vladiclick/hx18-hexapod/final-concept-st3215/renders/HX18-ST3215-underside.png

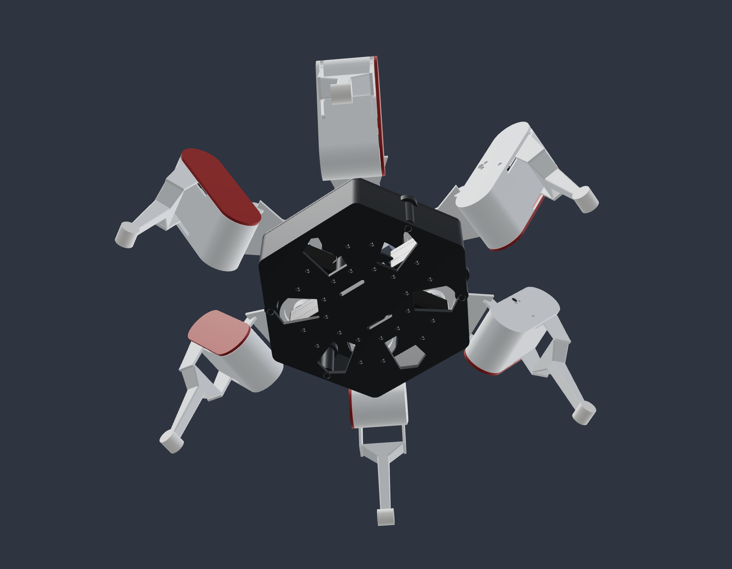
final-concept-st3215/renders/HX18-ST3215-underside.png
