vladiclick/hx18-hexapod/final-concept/HX18-Core-open.png

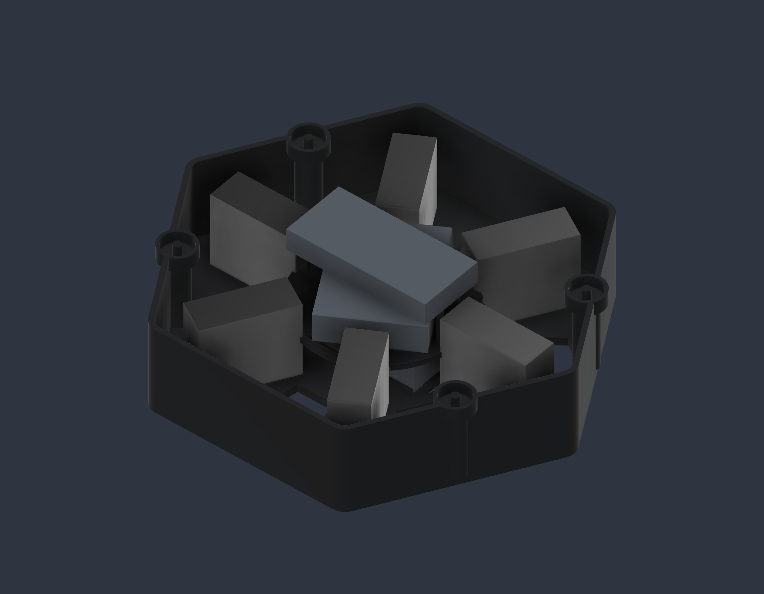
final-concept/HX18-Core-open.png
