vladiclick/hx18-hexapod/final-concept/HX18-Inline-V5-preview.png

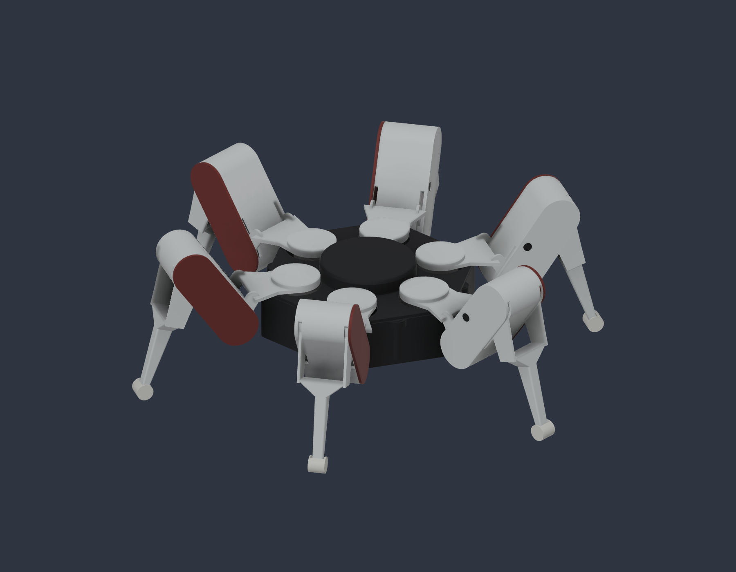
final-concept/HX18-Inline-V5-preview.png
