vladiclick/hx18-hexapod/final-concept/HX18-Top.png

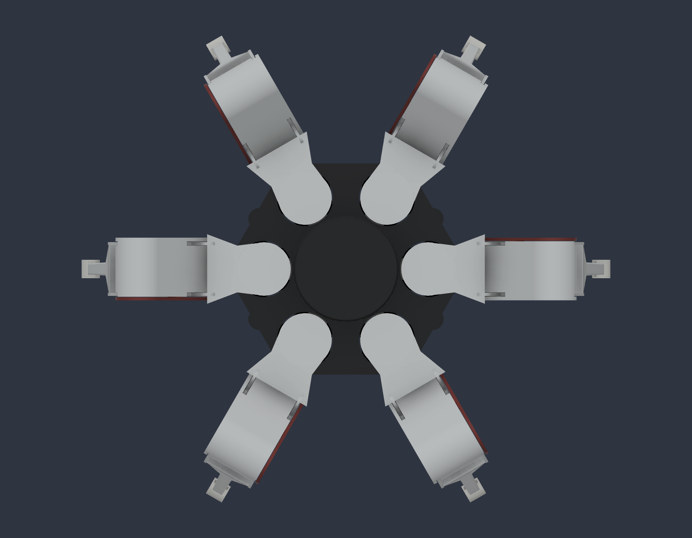
final-concept/HX18-Top.png
