vladiclick/hx18-hexapod/final-concept/HX18-Underside.png

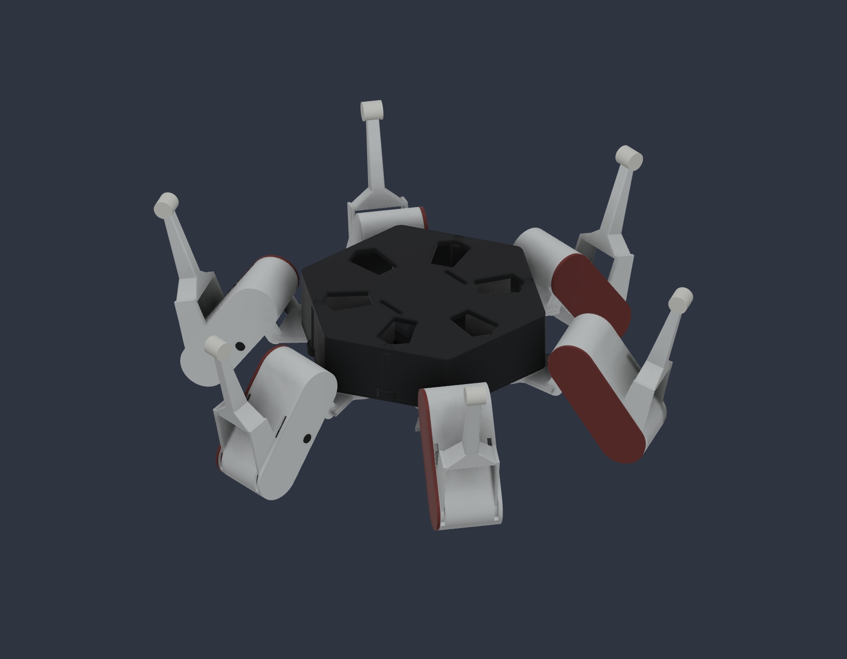
final-concept/HX18-Underside.png
