vladiclick/hx18-hexapod/final-concept/V5-One-leg-edge.png

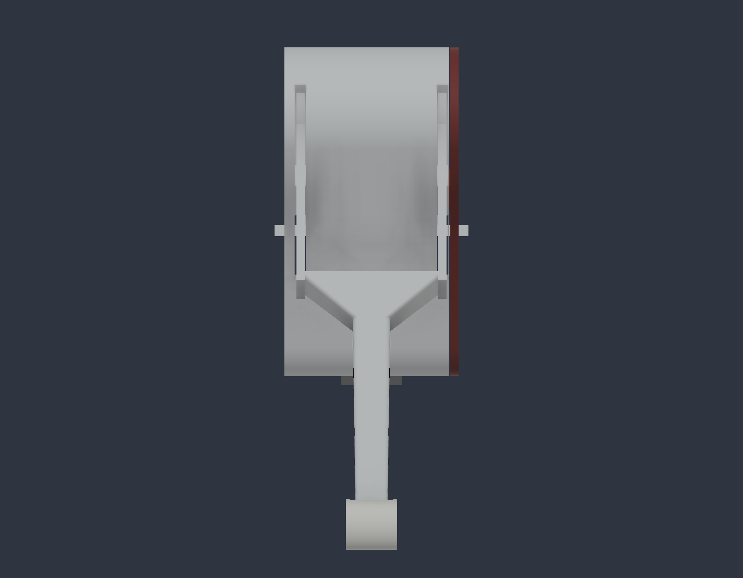
final-concept/V5-One-leg-edge.png
