vladiclick/hx18-hexapod/final-concept/V5-One-leg-front.png

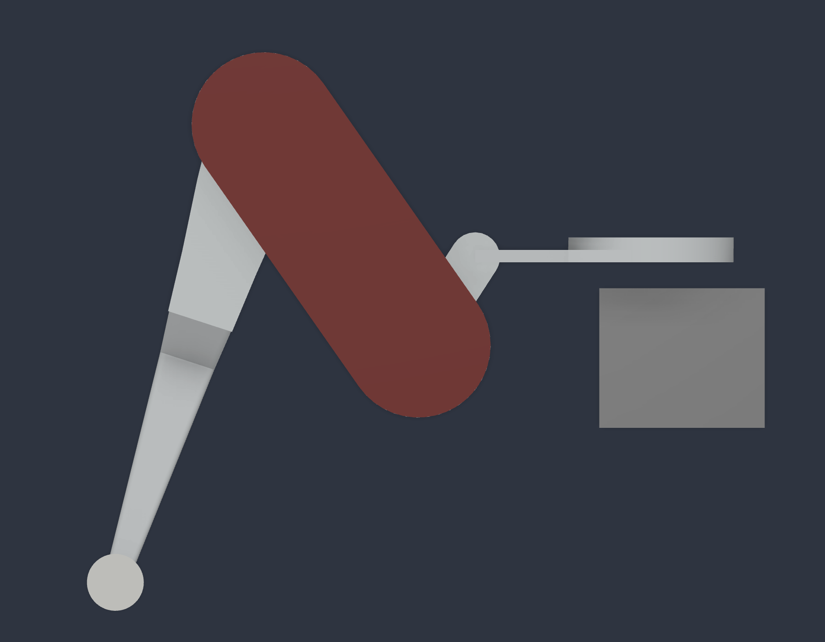
final-concept/V5-One-leg-front.png
