vladiclick/hx18-hexapod/final-concept/V5-One-leg-rear.png

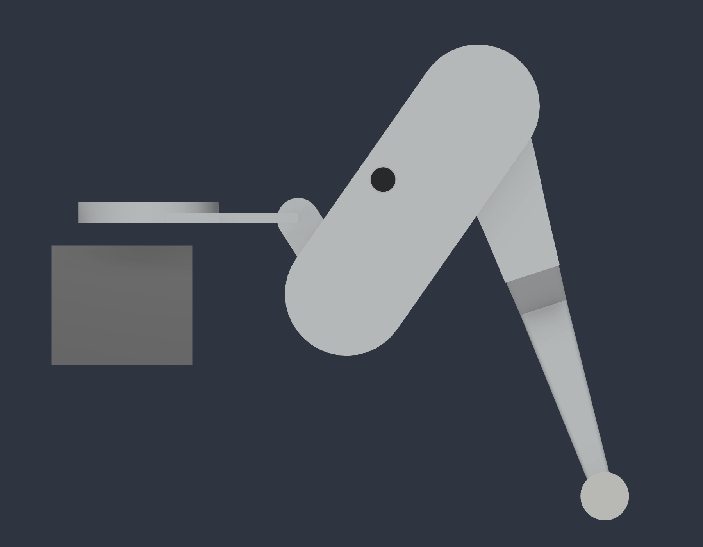
final-concept/V5-One-leg-rear.png
