vladiclick/hx18-hexapod/v2/Core-electronics.png

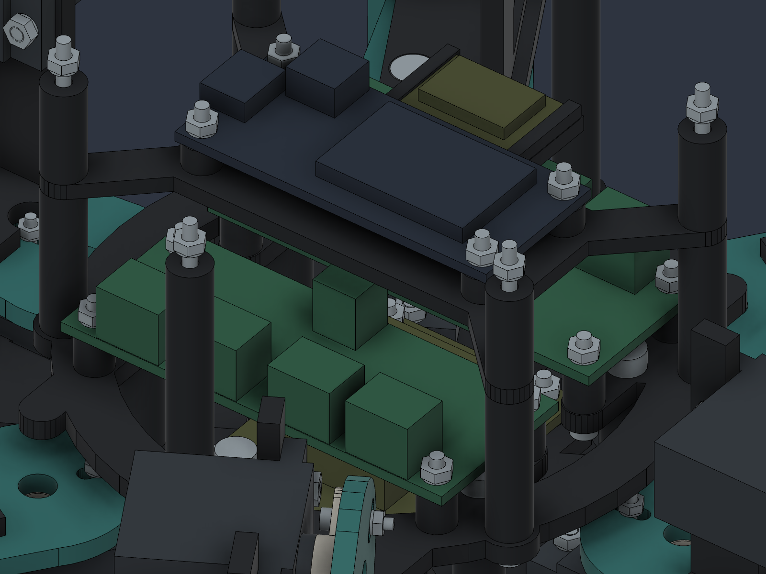
v2/Core-electronics.png
