vladiclick/hx18-hexapod/v2/Core-PCA-power.png

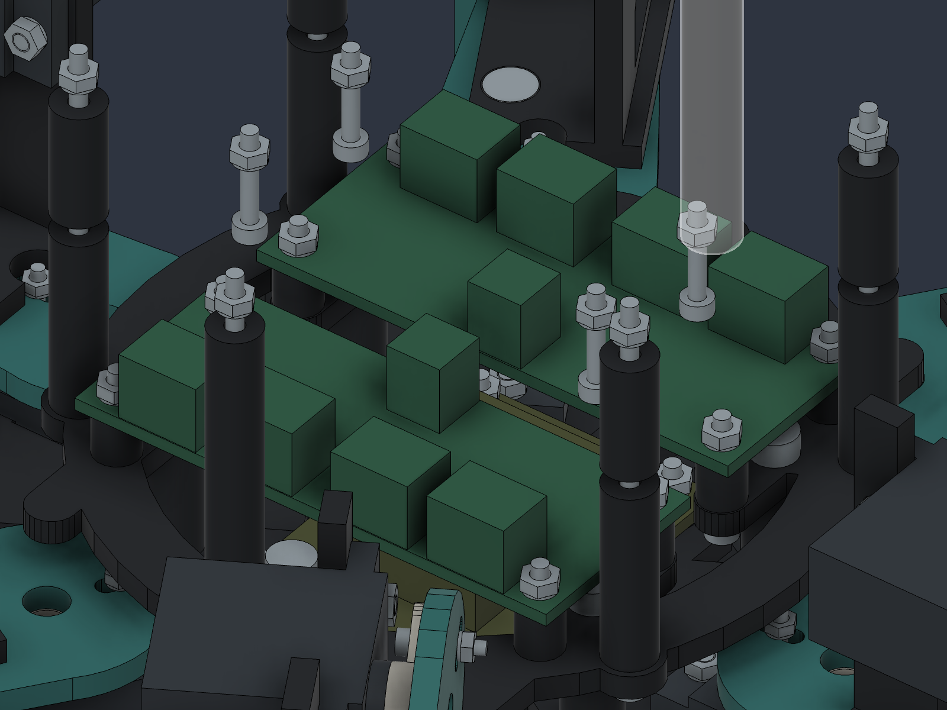
v2/Core-PCA-power.png
