vladiclick/hx18-hexapod/v2/HX18-preview.png

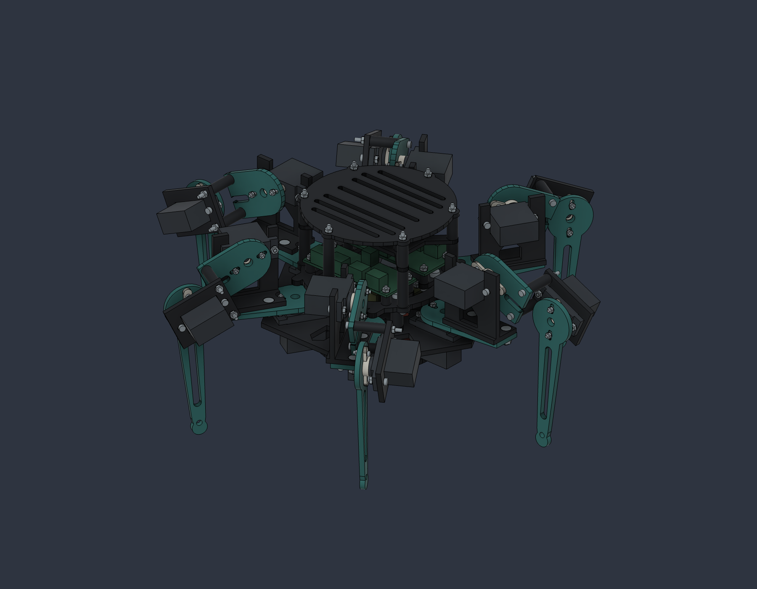
v2/HX18-preview.png
