vladiclick/hx18-hexapod/v2/Electronics/BOM-electronics.csv

Referință | Cantitate | Statut selecție | Componentă | Model/specificație | L_mm | W_mm | H_mm | Masă_per_unitate_g | Rol și observații | Sursă primară | Validare rămasă
MCU1 | 1 | produs exact | Adafruit Feather ESP32 V2 fără header-e GPIO înalte | 5400 | 50.8 | 22.86 | 6.37 | 6 | PCB50.8x22.86; produs overall52.3x22.8x7.2; USB-C | https://www.adafruit.com/product/5400 | pini/găuri oficiale; PCB real de verificat
PWM-A;PWM-B | 2 | produs exact | Adafruit PCA9685 16 Channel PWM Servo Driver | 815 rev C | 62.23 | 25.4 | 12.10 | 9 | înălțime model: z−2.01..10.09; V+ neconectat în topologia externă | https://www.adafruit.com/product/815 | 0x40 și0x41; A0 numai pe B
REG-S | 1 | produs exact | Pololu 5V Step-Down D42V110F5 | 5671 | 31.75 | 43.18 | 9 | 15 | 5V±3%; 8–15A tipic dependent de VIN/răcire | https://www.pololu.com/product/5671 | teste la VIN6.6–8.4V și sarcina reală
REG-L | 1 | produs exact | Pololu 5V 1A Step-Down D24V10F5 | 2831 | 12.7 | 17.78 | 3.56 | 1 | logică prin cablu USB-C; nu alimentează servouri | https://www.pololu.com/product/2831/specs | cradle izolator fără găuri
BAT1 | 1 | produs exact | Gens ace Adventure 450mAh 2S 60C | GEA4502S60XT3 | 43 | 23 | 13 | 28 | 7.4Vnominal/8.4Vfull; XT30; G-Tech-3P pentru încărcare | https://gensace.de/fr/collections/product-download/products/gea4502s60xt3 | dimensiuni și masă aproximative; disponibilitate de confirmat
SV0..SV17 | 18 | produs exact | TowerPro MG90S metal gear | MG90S | 22.8 | 12.2 | 28.5 | 13.4 | 1.8kgfcm stall@4.8V; curent stall nepublicat oficial | https://towerpro.com.tw/product/mg90s-3/ | modele și horn-uri reale de verificat; clonele diferă
R-OE | 1 | specificație | Rezistor axial metal-film | 1kΩ 1% minimum0.125W |  |  |  |  | OE comun→Feather3V; ambele R7 de10kΩ păstrate | https://github.com/adafruit/Adafruit-16-Channel-PWM-Servo-Driver-PCB | valoare proiectată; nu cod de achiziție
C-A;C-B | 2 | specificație | Condensator electrolitic low-ESR | 1000µF minimum10V |  |  |  |  | câte unul pe fiecare bancă5V; polaritate corectă |  | alegere inițială; produs/dimensiuni după măsurători
F1 | 1 | specificație provizorie | Siguranță fuzibilă DC pentru intrare | 7A țintă provizorie |  |  |  |  | rating DC≥12V; valoarea/curba verificate cu curent real | https://www.littelfuse.com/assetdocs/automotive-passenger-car-catalog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 | 7A nu este7A limită la ieșire; nu cod comandabil definit
FH1 | 1 | specificație | Portsiguranță inline izolat | compatibil F1 și curentul ramurii |  |  |  |  | montaj aproape de pozitiv BAT; clemă/strain-relief |  | gabarit adaptat după produs real
D0;D1;HARNESS | 2 | specificație | Pereche mufă XT30 plus fire izolate | tip compatibil exact cu bateria |  |  |  |  | D0baterie; D1deconectare ramură VIN servo; contacte potrivite |  | sex/polaritate verificate; nu scurtcircuita; mase comune
USB-PWR | 1 | specificație | Cablu USB-C conform pentru alimentare | scurt cu VBUS/GND identificate |  |  |  |  | buck logic5V→USB-CFeather; scos înainte de USB computer |  | mufa/cablul real determină keepout
ADAPTER0..17 | 18 | specificație | Adaptor/prelungitor JR servo | semnal separat de +/GND |  |  |  |  | oranj→PCA PWM; roșu/maro→distribuție externă |  | contacte și polaritate verificate; nu Dupont pentru magistrala putere
PWR-WIRE | 1 | specificație | Set fire flexibile silicon | 18AWG principal;22AWG ramură picior |  |  |  |  | lungime după rutarea CAD; curent/cădere tensiune verificate |  | secțiuni propuse pentru trasee scurte; ajustează după test
LOGIC-WIRE | 1 | specificație | Set5 fire logică/GND pentru două plăci | 26–28AWG izolate |  |  |  |  | 3V,GND,SDA,SCL,OE; fire scurte |  | conectori/sudură cu strain-relief
BMS/MON | 1 | necesar înainte de mers pe baterie | Monitor/protector LiPo2S pe fiecare celulă | compatibilG-Tech-3P; prag validat |  |  |  |  | firmware ADC și protecție hardware nu sunt instalate |  | nu este inclus/fictiv; alege după pack real
CHARGER | 1 | echipament extern | Încărcător balance2S LiPo | compatibilG-Tech-3P +XT30 |  |  |  |  | bateria scoasă/deconectată de robot; încărcare echilibrată | https://gensace.de/fr/collections/product-download/products/gea4502s60xt3 | nu se încarcă din Feather USB
HW-PCB | 12 | specificație | Set M2 șurub+șaibă/distanțier izolat | lungime măsurată |  |  |  |  | 4Feather+8PCA; găurile PCB nu acceptăM3 |  | diametru/lungime validate pe print real
HW-REG | 4 | specificație | Set M2 pentru buck servo | M2×10mm; lungime finală verificată |  |  |  |  | găuriØ2.18; componente sub PCB1.8mm |  | cradle pentru bucklogic fără găuri
