vladiclick/hx18-hexapod/final-concept/final-concept-assembly.stl

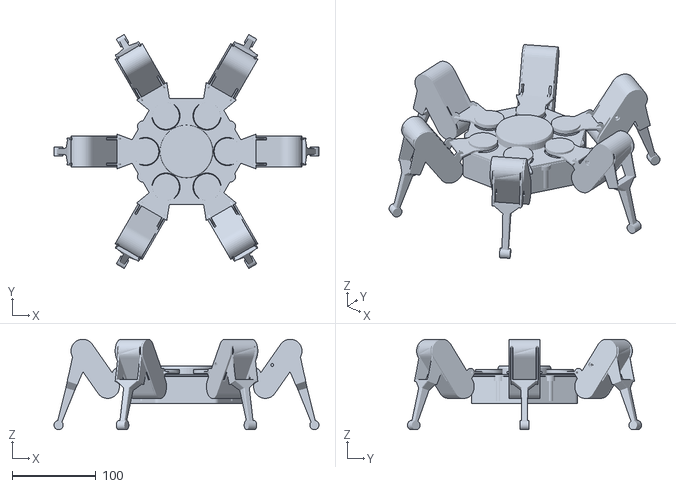
[picture p21: CAD file, 2026-10-26]
final-concept/final-concept-assembly.stl
316.1 x 279.3 x 107.9
