vladiclick/hx18-hexapod/final-concept-st3215/hx18-final-concept-st3215.step

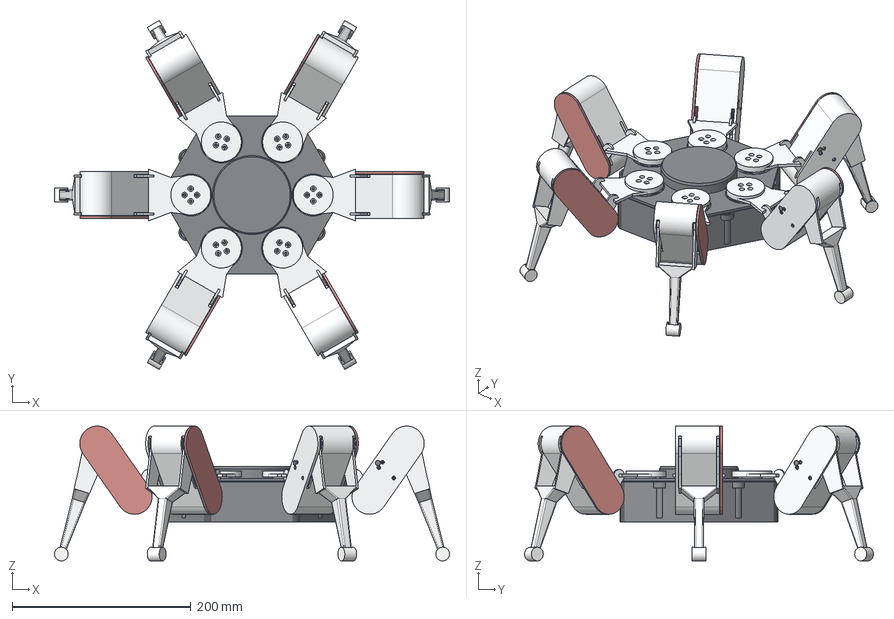
[picture p22: CAD file, 2026-10-28]
final-concept-st3215/hx18-final-concept-st3215.step
442.6 x 391.0 x 151.1 mm
Core tub
Core lid
Electronics cassette
Battery keep-out
Regulator keep-out
ESP32 keep-out
Lid screw M3x40 1 x 4
Cassette screw M3x6 1 x 2
coxa x 6
femur x 6
femur cover x 6
tibia x 6
foot pad x 6
middle case x 18
top case x 18
bottom case x 18
drive horn x 18
idler horn x 18
Leg 1 cover screw M3x45 x 6
