vladiclick/hx18-hexapod/final-concept-st3215/STL/FootPad.stl

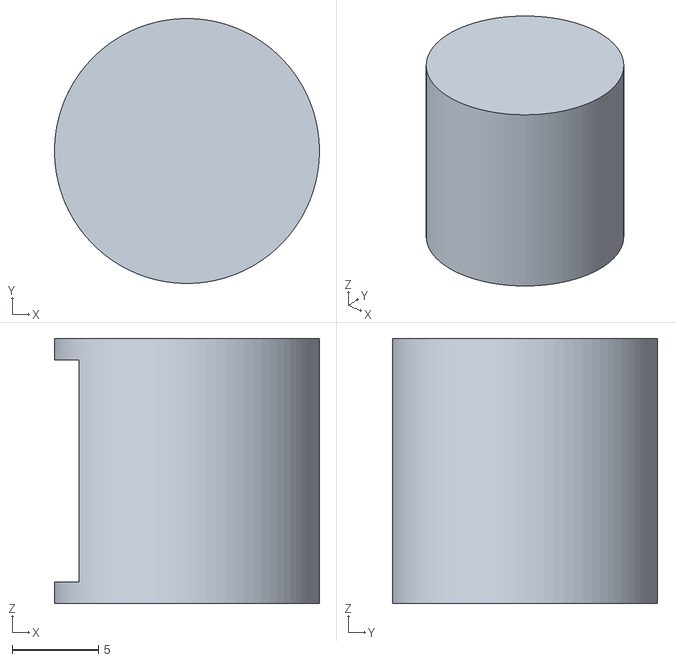
[picture p23: CAD file, 2026-10-28]
final-concept-st3215/STL/FootPad.stl
15.4 x 15.4 x 15.4
