vladiclick/hx18-hexapod/v2/HX18-MG90S.step

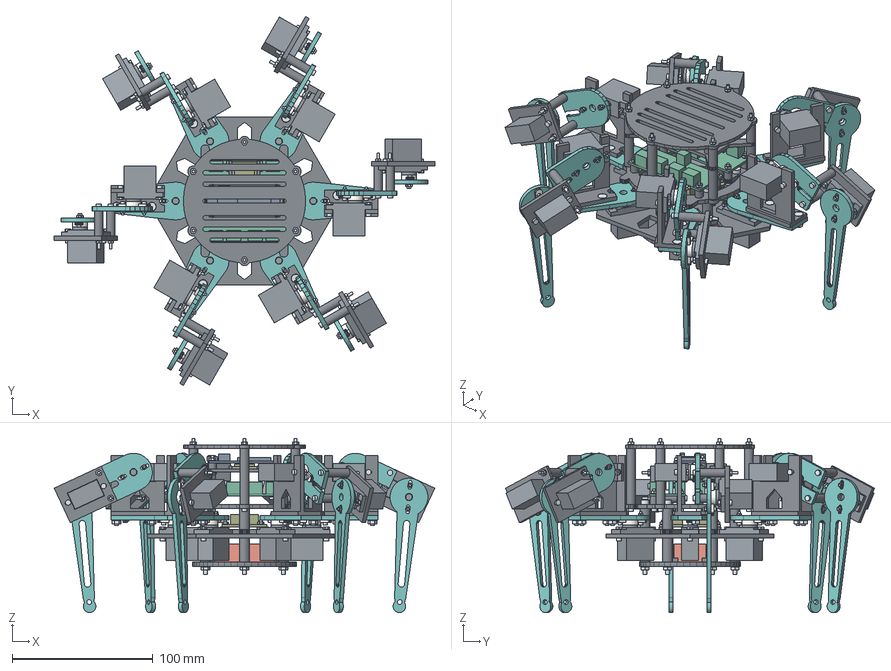
[picture p24: CAD file, 2026-10-26]
v2/HX18-MG90S.step
270.9 x 262.6 x 124.0 mm
