vladiclick/hx18-hexapod/v2/STL/GuardLower.stl

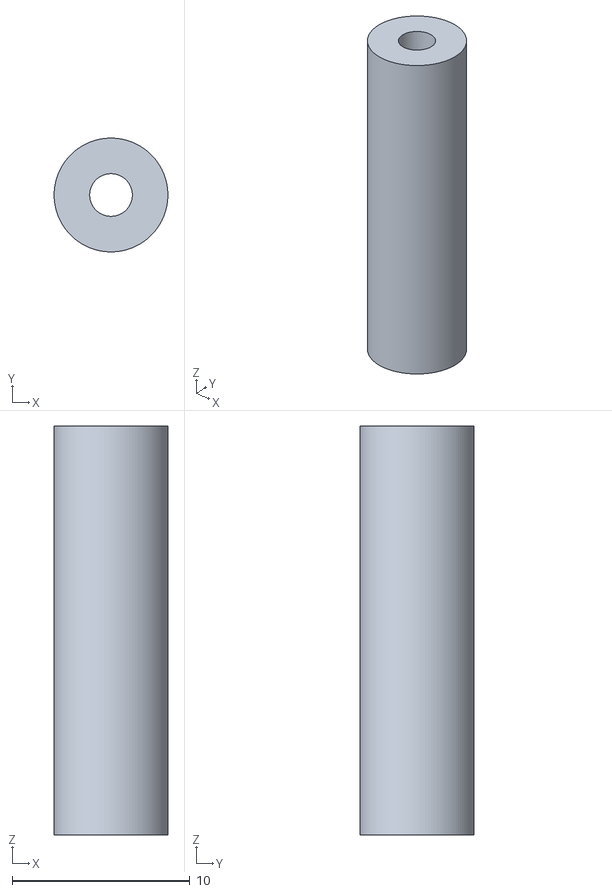
[picture p25: CAD file, 2026-10-26]
v2/STL/GuardLower.stl
6.40 x 6.40 x 23.0
