vladiclick/hx18-hexapod/final-concept-st3215/hx18-final-concept-st3215-printed-parts.stl

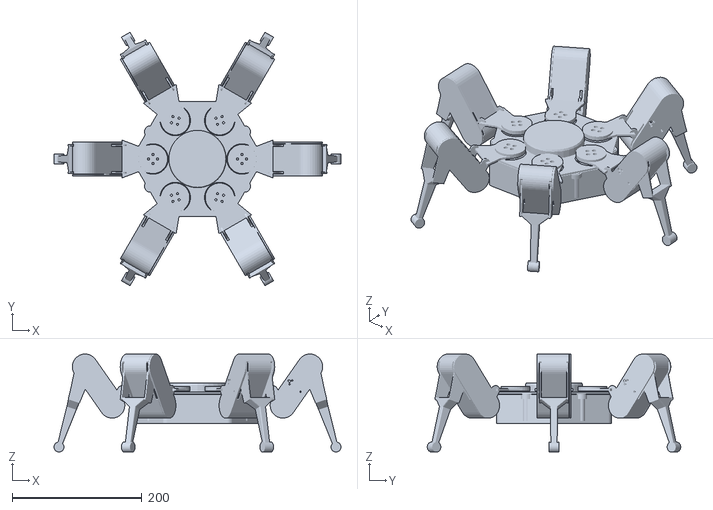
[picture p26: CAD file, 2026-10-28]
final-concept-st3215/hx18-final-concept-st3215-printed-parts.stl
442.5 x 390.9 x 151.1
