vladiclick/hx18-hexapod/final-concept-st3215/STL/ElectronicsCassette.stl

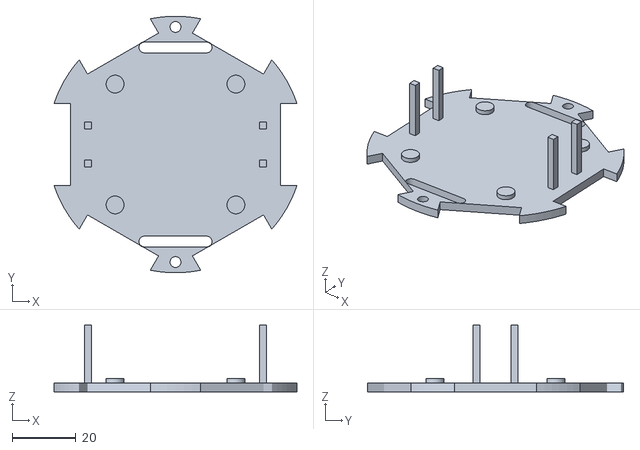
[picture p27: CAD file, 2026-10-28]
final-concept-st3215/STL/ElectronicsCassette.stl
76.4 x 80.6 x 21.0
