vladiclick/hx18-hexapod/final-concept/final-concept.step

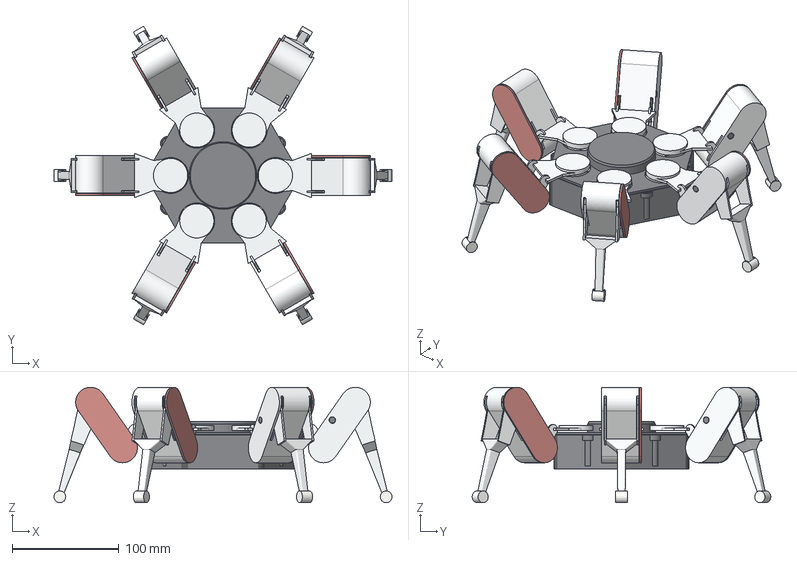
[picture p28: CAD file, 2026-10-26]
final-concept/final-concept.step
316.1 x 279.3 x 107.9 mm
