vladiclick/hx18-hexapod/v2/STL/UpperSpacer.stl

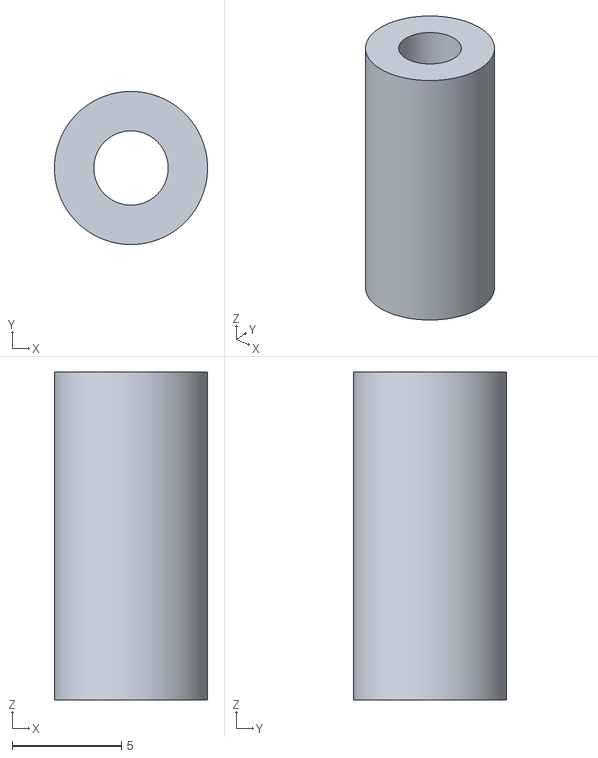
[picture p29: CAD file, 2026-10-26]
v2/STL/UpperSpacer.stl
7.00 x 7.00 x 15.0
