vladiclick/hx18-hexapod/final-concept-st3215/STL/FemurCheek.stl

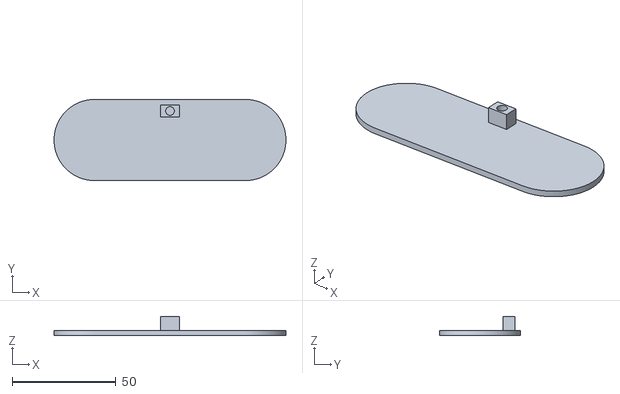
[picture p30: CAD file, 2026-10-28]
final-concept-st3215/STL/FemurCheek.stl
112.0 x 39.2 x 9.18
