vladiclick/hx18-hexapod/v2/STL/Chassis.stl

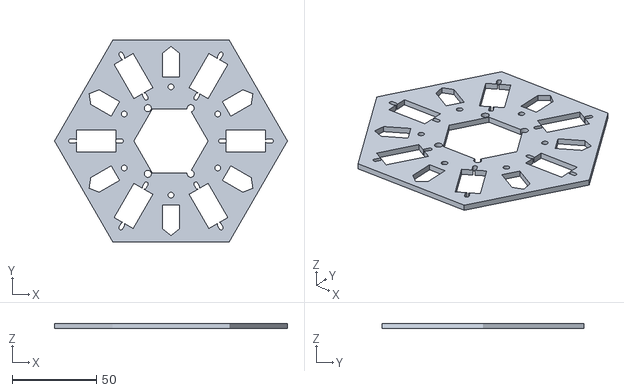
[picture p31: CAD file, 2026-10-26]
v2/STL/Chassis.stl
138.0 x 119.5 x 3.00
