vladiclick/hx18-hexapod/final-concept-st3215/STL/CoreTub.stl

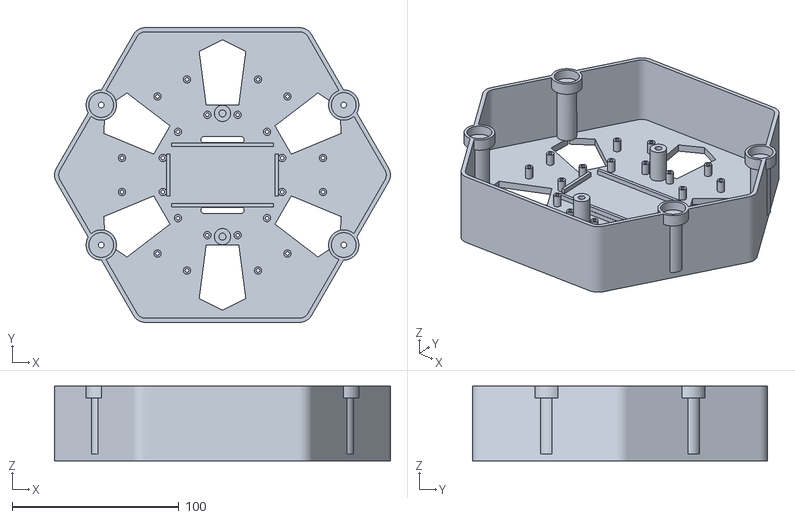
[picture p32: CAD file, 2026-10-28]
final-concept-st3215/STL/CoreTub.stl
201.6 x 176.8 x 44.8
