vladiclick/hx18-hexapod/v2/STL/FitCoupon.stl

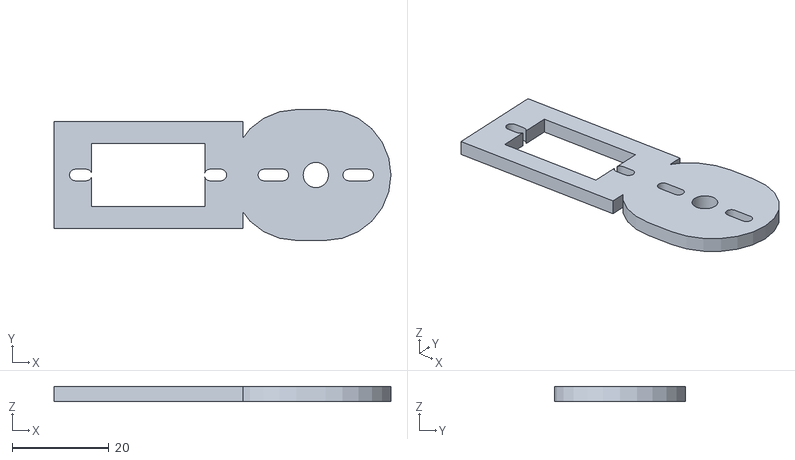
[picture p33: CAD file, 2026-10-26]
v2/STL/FitCoupon.stl
69.5 x 27.0 x 3.00
