vladiclick/hx18-hexapod/final-concept-st3215/STL/Tibia.stl

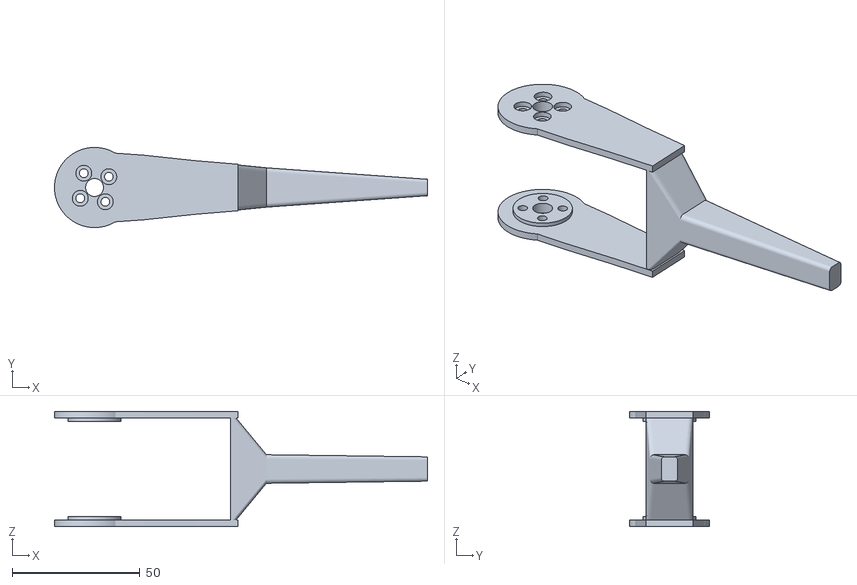
[picture p34: CAD file, 2026-10-28]
final-concept-st3215/STL/Tibia.stl
145.9 x 31.4 x 45.1
