vladiclick/hx18-hexapod/v2/STL/GuardTall.stl

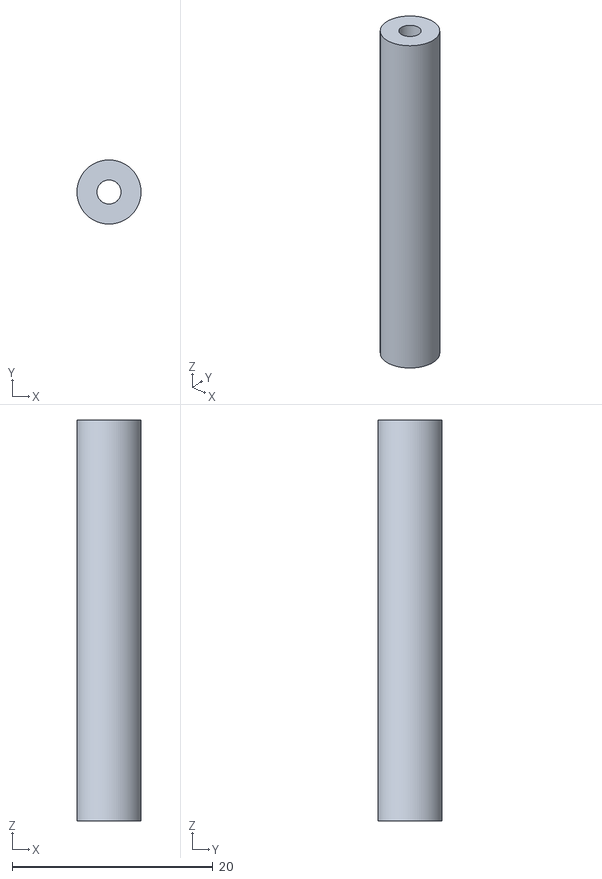
[picture p35: CAD file, 2026-10-26]
v2/STL/GuardTall.stl
6.40 x 6.40 x 40.0
