vladiclick/hx18-hexapod/final-concept-st3215/STL/CoreLid.stl

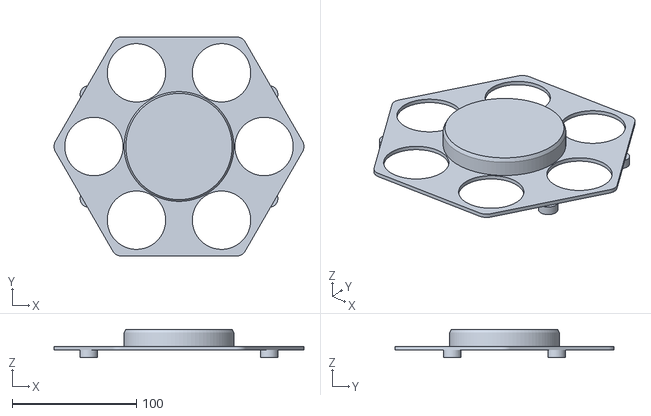
[picture p36: CAD file, 2026-10-28]
final-concept-st3215/STL/CoreLid.stl
201.6 x 176.8 x 23.0
