vladiclick/hx18-hexapod/v2/STL/GuardUpper.stl

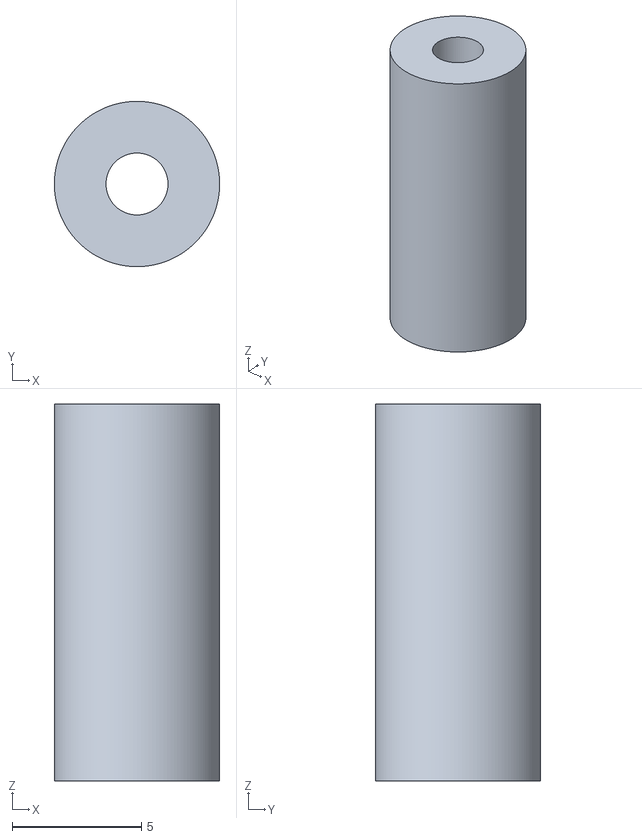
[picture p37: CAD file, 2026-10-26]
v2/STL/GuardUpper.stl
6.40 x 6.40 x 14.6
