vladiclick/hx18-hexapod/final-concept-st3215/STL/CoxaCarrier.stl

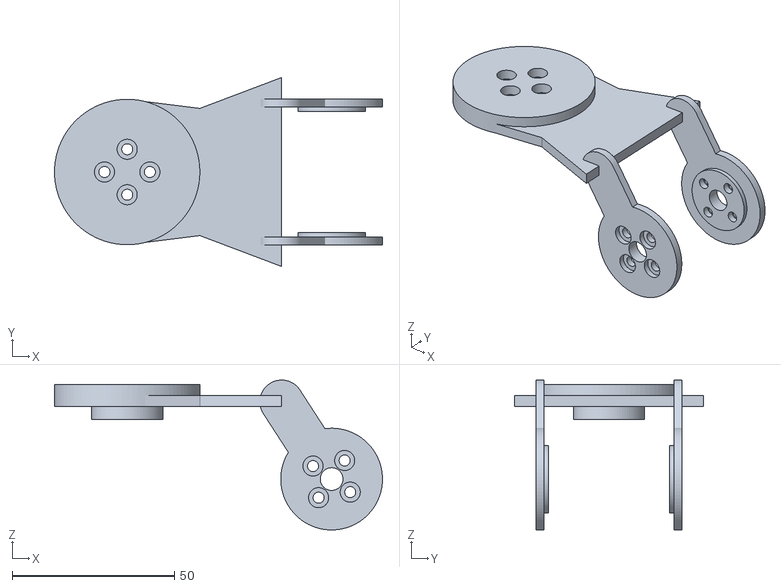
[picture p38: CAD file, 2026-10-28]
final-concept-st3215/STL/CoxaCarrier.stl
101.1 x 58.2 x 46.2
