vladiclick/hx18-hexapod/v2/STL/Tibia.stl

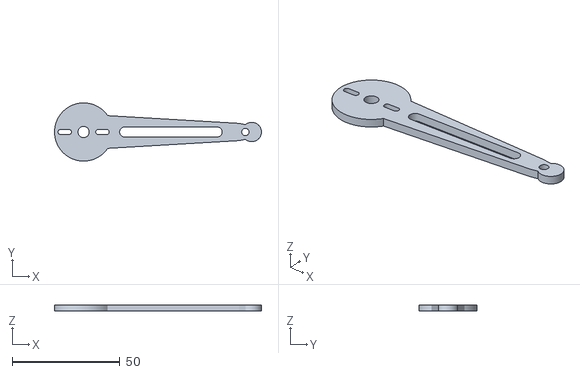
[picture p39: CAD file, 2026-10-26]
v2/STL/Tibia.stl
96.0 x 27.0 x 3.00
