vladiclick/hx18-hexapod/final-concept-st3215/STL/FemurCarrier.stl

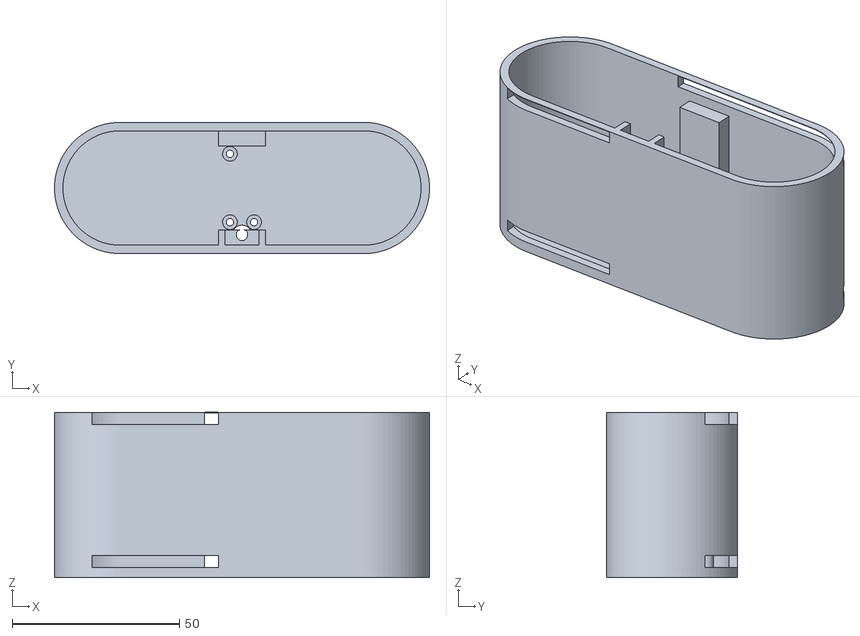
[picture p40: CAD file, 2026-10-28]
final-concept-st3215/STL/FemurCarrier.stl
112.0 x 39.2 x 49.4
