vladiclick/hx18-hexapod/v2/STL/CoreBridge.stl

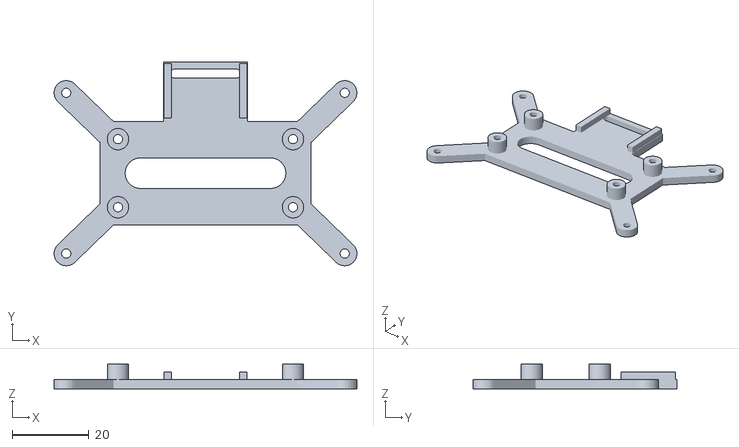
[picture p41: CAD file, 2026-10-26]
v2/STL/CoreBridge.stl
79.1 x 53.2 x 6.40
