vladiclick/hx18-hexapod/v2/STL/FemurPlate.stl

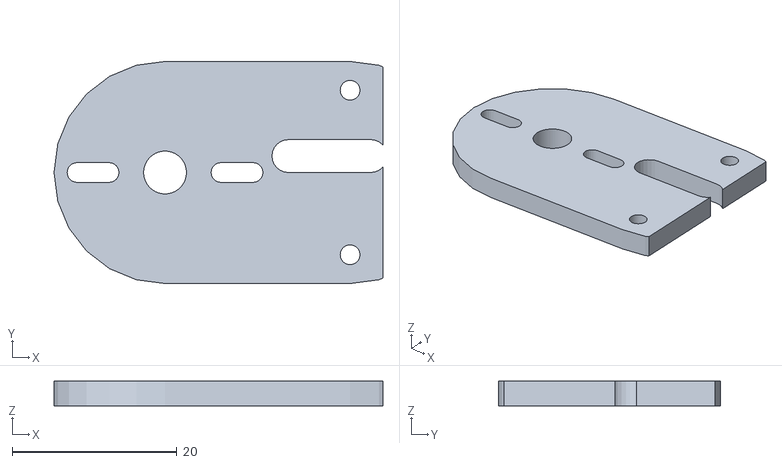
[picture p42: CAD file, 2026-10-26]
v2/STL/FemurPlate.stl
40.0 x 27.0 x 3.00
