vladiclick/hx18-hexapod/v2/STL/HipBracket.stl

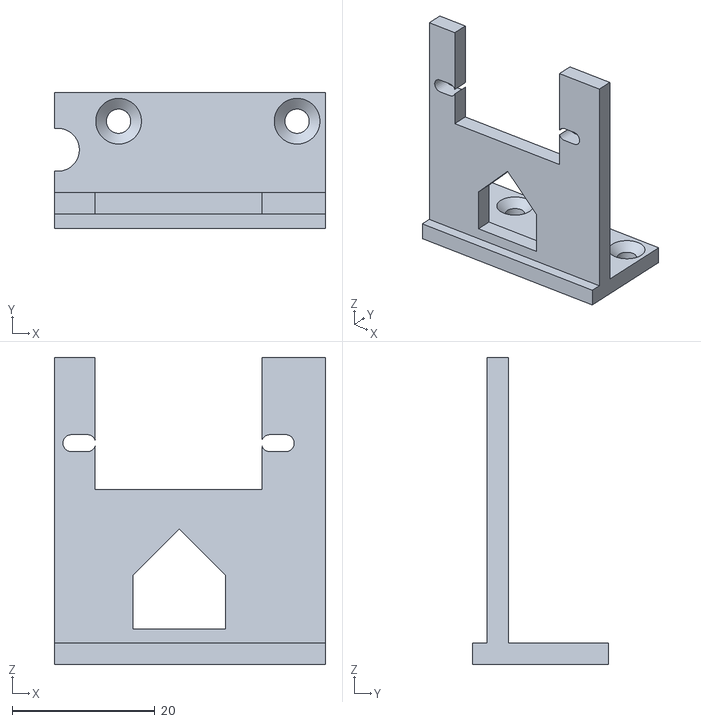
[picture p43: CAD file, 2026-10-26]
v2/STL/HipBracket.stl
38.0 x 19.0 x 43.0
