vladiclick/hx18-hexapod/v2/STL/LowerDeck.stl

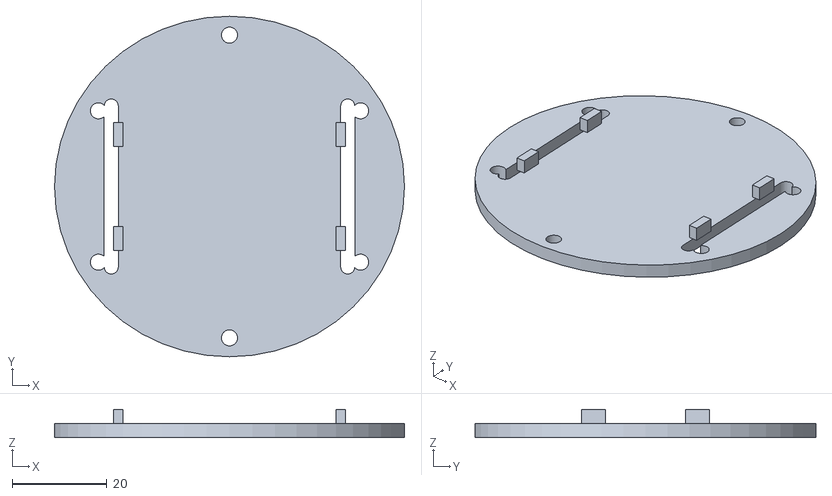
[picture p44: CAD file, 2026-10-26]
v2/STL/LowerDeck.stl
74.0 x 72.0 x 6.00
