vladiclick/hx18-hexapod/v2/STL/CoreCap.stl

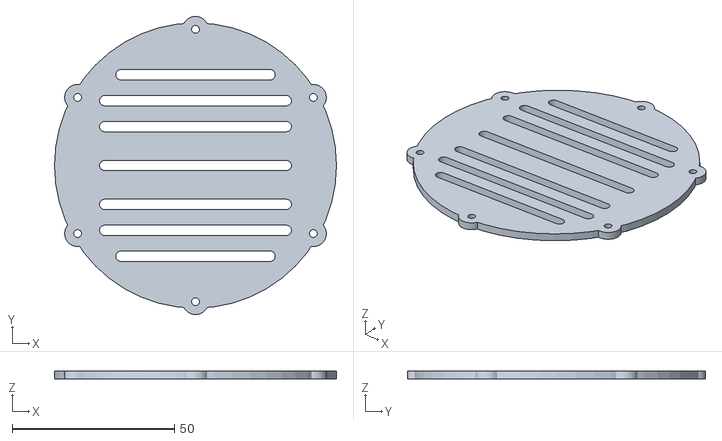
[picture p45: CAD file, 2026-10-26]
v2/STL/CoreCap.stl
87.0 x 92.0 x 2.40
