vladiclick/hx18-hexapod/v2/STL/KneeMount.stl

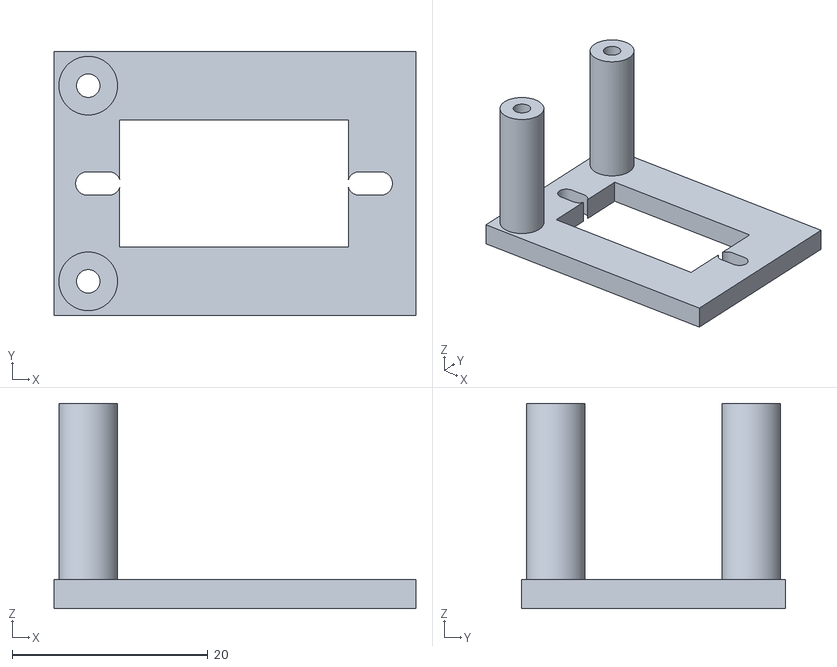
[picture p46: CAD file, 2026-10-26]
v2/STL/KneeMount.stl
37.0 x 27.0 x 21.0
