vladiclick/hx18-hexapod/v2/STL/CoxaPlate.stl

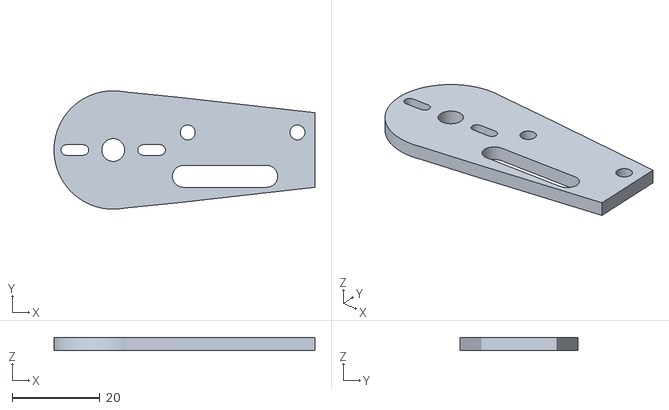
[picture p47: CAD file, 2026-10-26]
v2/STL/CoxaPlate.stl
59.5 x 27.0 x 3.00
