vladiclick/hx18-hexapod/v2/STL/PowerShelf.stl

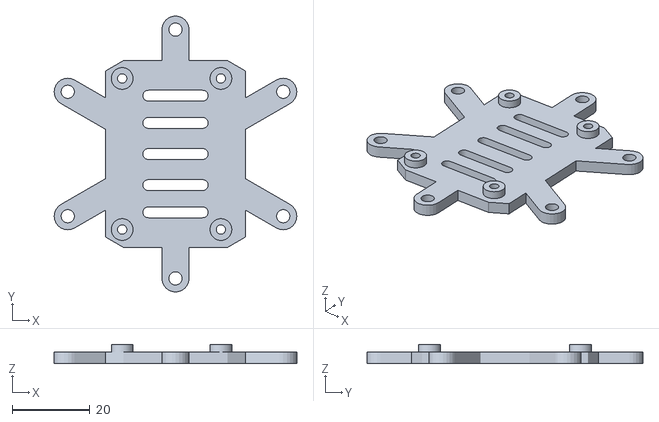
[picture p48: CAD file, 2026-10-26]
v2/STL/PowerShelf.stl
62.4 x 71.0 x 5.00
