vladiclick/hx18-hexapod/v2/STL/ElectronicsDeck.stl

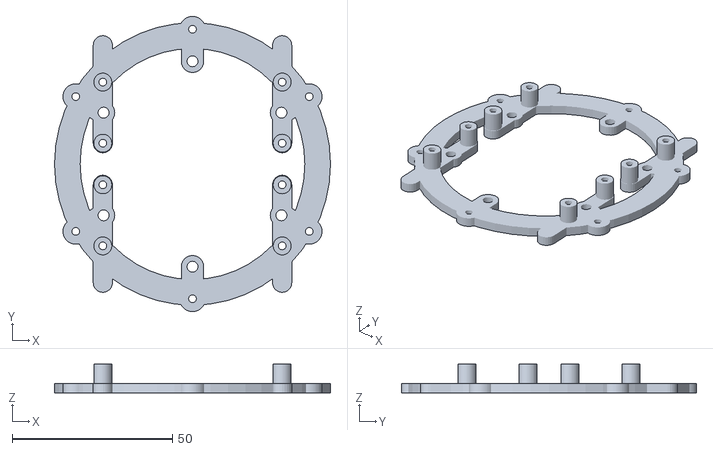
[picture p49: CAD file, 2026-10-26]
v2/STL/ElectronicsDeck.stl
86.0 x 92.0 x 9.00
