vladiclick/hx18-hexapod/v2/STL/LowerSpacer.stl

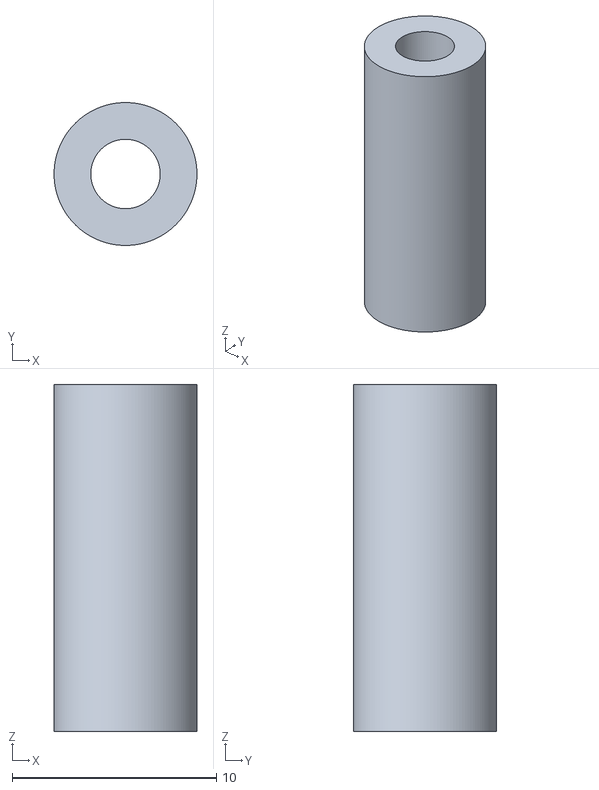
[picture p50: CAD file, 2026-10-26]
v2/STL/LowerSpacer.stl
7.00 x 7.00 x 17.0
