vladiclick/hx18-hexapod/(list of files, cad)

Other CAD files:
final-concept/STL/CoreLid.stl
final-concept/STL/CoreTub.stl
final-concept/STL/CoxaCarrier.stl
final-concept/STL/ElectronicsCassette.stl
final-concept/STL/FemurCarrier.stl
final-concept/STL/FemurCheek.stl
final-concept/STL/FootPad.stl
final-concept/STL/Tibia.stl
final-concept/final-concept.f3d
v2/HX18-MG90S.f3d
v2/Original-Sketch.f3d
