vladiclick/hx18-hexapod/v2/Electronics/wiring-preview.png

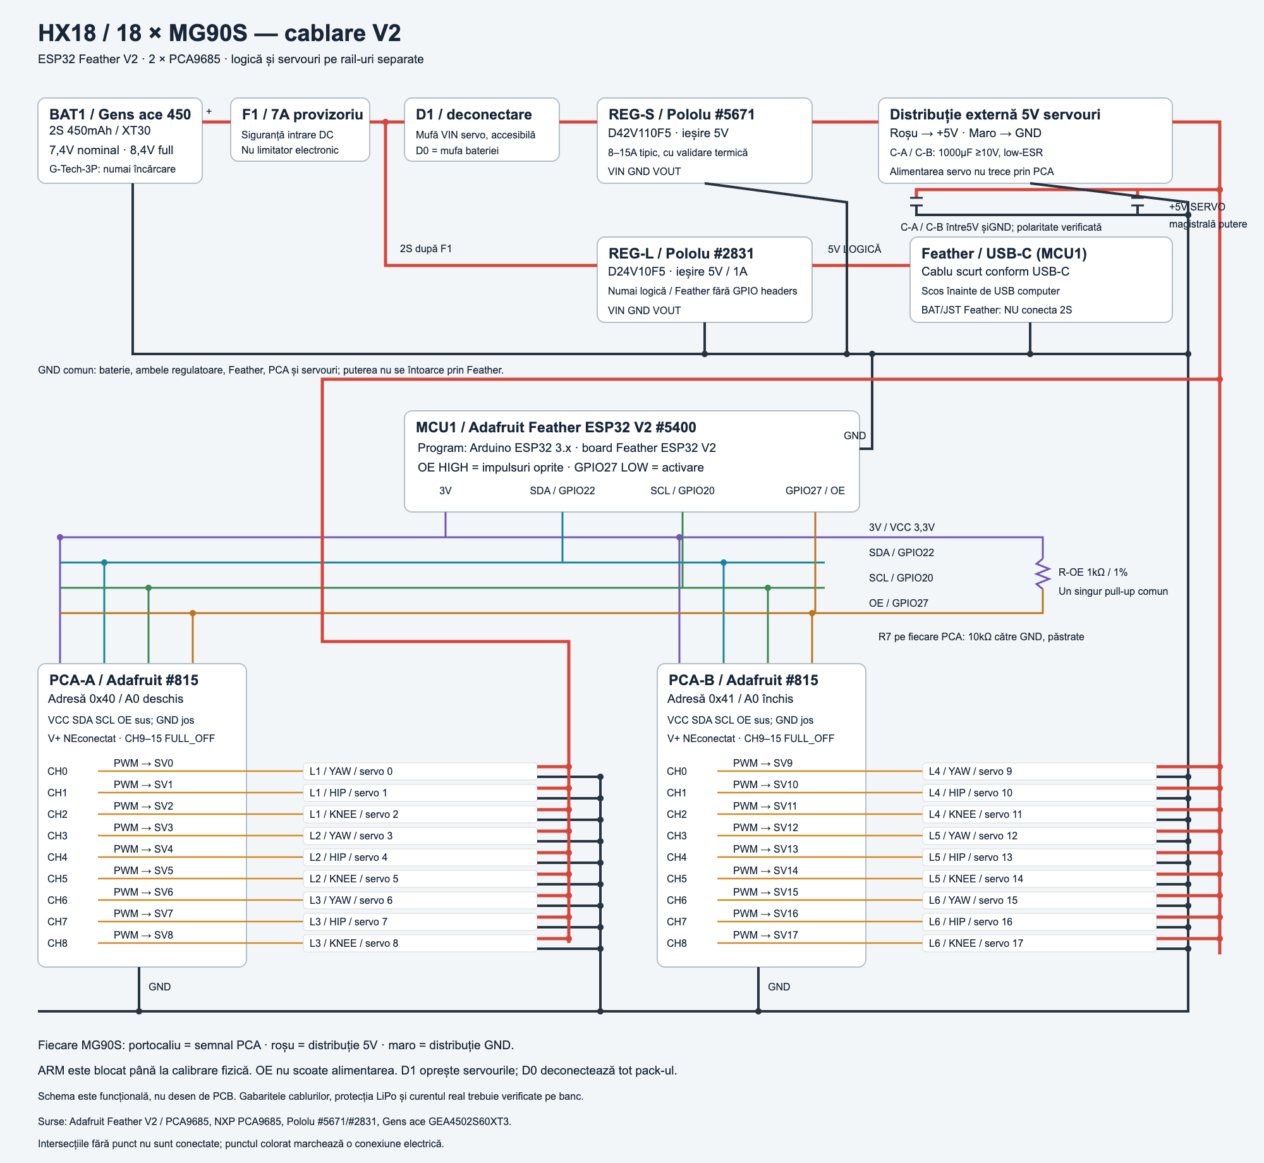
v2/Electronics/wiring-preview.png
