vladiclick/hx18-hexapod/(commit log)

2026-10-26 Make "final concept" the main design, move V2 to v2/
    final-concept/ holds the design saved in Fusion as "final concept"
    (F3D and STEP exported from the cloud version, a posed assembly STL),
    the 8 bed-oriented print parts, the print BOM, the generator script
    with its tests and the validation reports. The earlier MG90S version
    with wiring and ESP32 firmware moves unchanged to v2/.
    [BOM-electronics.csv, BOM-mechanical.csv, Chassis.stl, CoreBridge.stl, CoreCap.stl, CoreLid.stl, CoreTub.stl, CoxaCarrier.stl]
2026-10-28 Redesign HX18 around 18 Waveshare ST3215 servos
    New main design in st3215/: every joint now uses the real ST3215, placed
    from Waveshare's official 3D model (vendor/, credited). Core, coxa, femur
    and tibia are regenerated in CadQuery around the real servo dimensions,
    with both horns of every servo bolted to the next link.
    Includes a coloured STEP of the whole robot, print-ready STLs, print and
    hardware BOMs, renders, a tripod-gait animation, and a validation report:
    no part overlaps, and no collisions over the joint ranges or the gait.
    final-concept/ stays as the previous version, v2/ as the MG90S build.
    [HARDWARE-BOM.csv, PRINT-BOM.csv, battery-bay.stl, core-lid.stl, core-tub.stl, coxa-cap.stl, coxa.stl, femur-cover.stl]
2026-10-28 Put 18 ST3215 servos in the final concept, without changing its design
    The previous ST3215 version replaced the final concept with a new design.
    This one keeps the concept's parts, shapes, colours and pose: the generator
    ports the concept's Fusion script feature by feature (scale 1 rebuilds the
    original parts exactly) and scales it 1.4x, the smallest scale at which the
    ST3215 fits every joint. Servo mounts are added inside the parts only.
    - final-concept-st3215/: coloured STEP with the official Waveshare model in
    all 18 joints, 8 print STLs, BOMs, renders and validation
    - no part overlaps; no contact over the concept's joint ranges
    - st3215/ (the redesign) removed; the vendor model moves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
    [CoreLid.stl, CoreTub.stl, CoxaCarrier.stl, ElectronicsCassette.stl, FemurCarrier.stl, FemurCheek.stl, FootPad.stl, HARDWARE-BOM.csv]
2026-10-29 Add a walking GIF: tripod gait with planted feet
    The gait stays inside the concept's free joint travel (50 mm steps, feet
    lifted 18 mm) and is collision-checked with all six legs. Stance feet do not
    slide and swing feet ease on and off the ground. The renderer gets a tiled
    floor and fog; one cycle moves the body exactly one tile, so the GIF loops.
    [build.py, gait.py]
